bkoropoff/sfc2md/(commit log)

2020-06-19 Initial Arduino sketch
2020-06-20 Bug fixes and refactoring
    [sfc2md.c]
2020-06-20 Optimize button decoding/encoding
2020-06-21 Allow forcing 3-button mode
